ZhuangHT-1201/three-blade-folding-hub/figures/asm_deployed.png

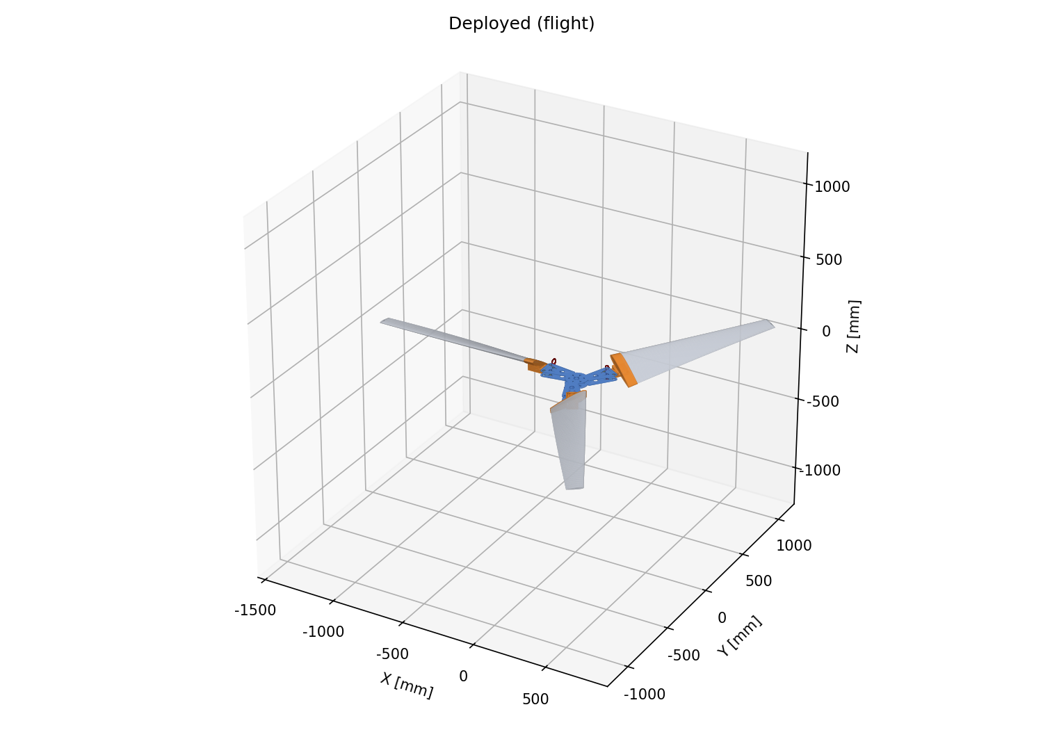
figures/asm_deployed.png
