ZhuangHT-1201/three-blade-folding-hub/figures/asm_midfold.png

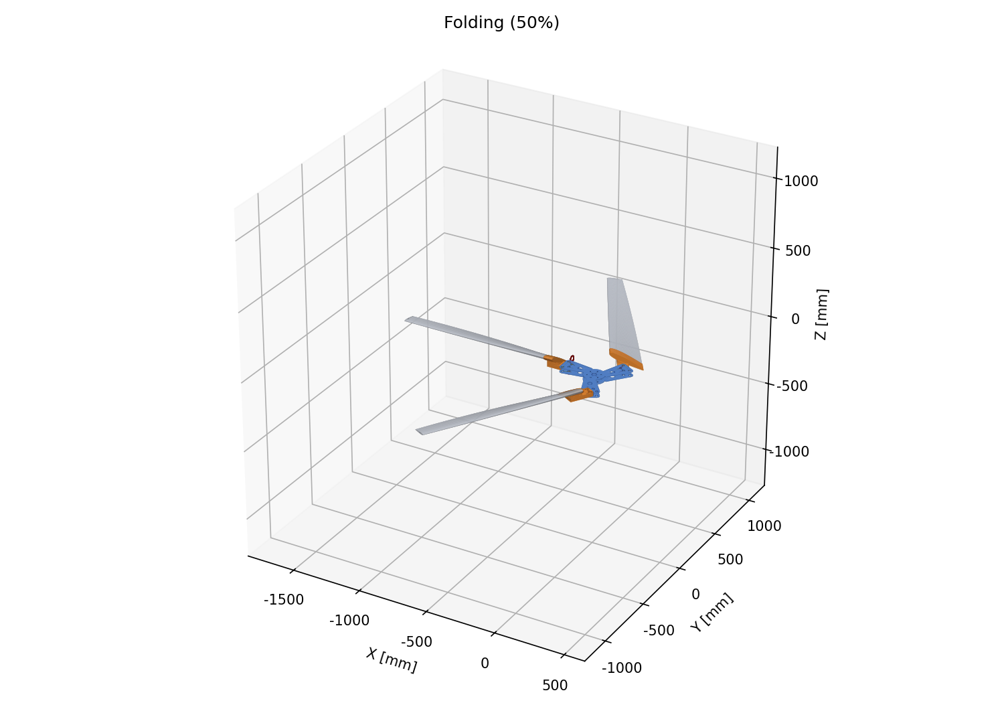
figures/asm_midfold.png
