ZhuangHT-1201/three-blade-folding-hub/preview.png

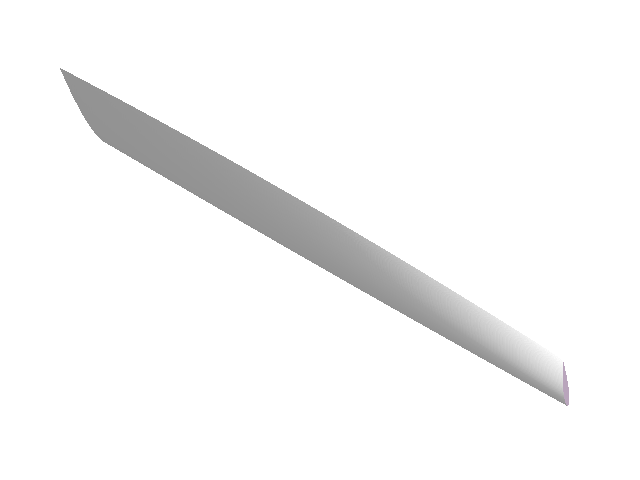
preview.png
