ZhuangHT-1201/three-blade-folding-hub/blade_rebuilt_mm.stl

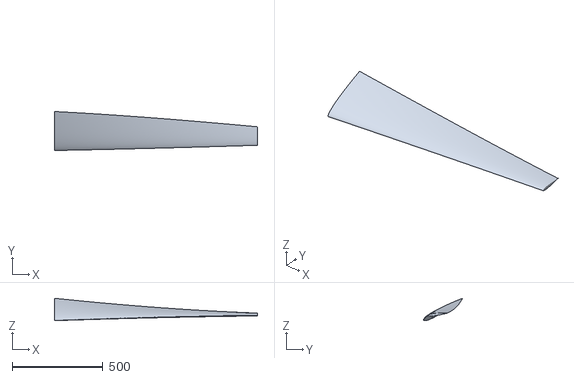
[picture p11: CAD file, 2026-10-12]
blade_rebuilt_mm.stl
1120.0 x 215.1 x 123.6
