ZhuangHT-1201/three-blade-folding-hub/blade_single.SLDPRT

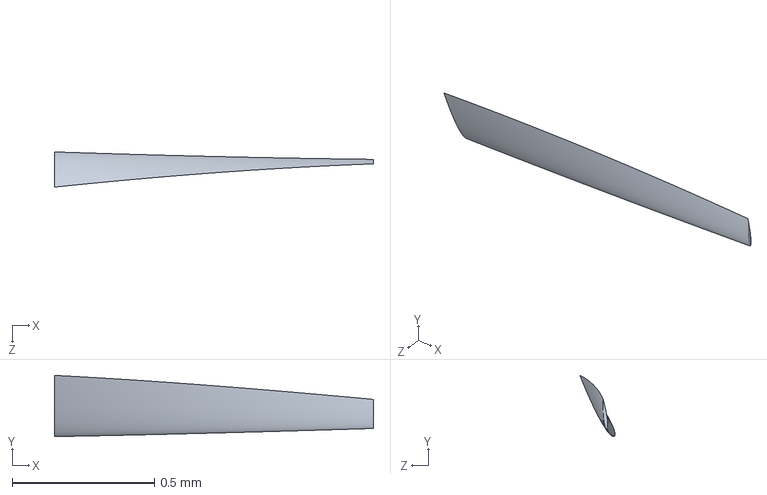
[picture p12: CAD file, 2026-10-12]
blade_single.SLDPRT
1.12 x 0.215 x 0.124 mm
