ZhuangHT-1201/three-blade-folding-hub/CAD/hub_spacer.step

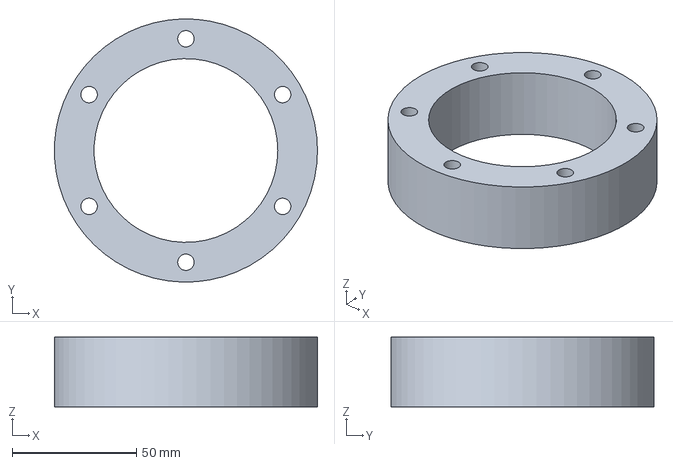
[picture p13: CAD file, 2026-10-12]
CAD/hub_spacer.step
105.9 x 106.0 x 28.0 mm
