ZhuangHT-1201/three-blade-folding-hub/CAD/hub_plate_lower.step

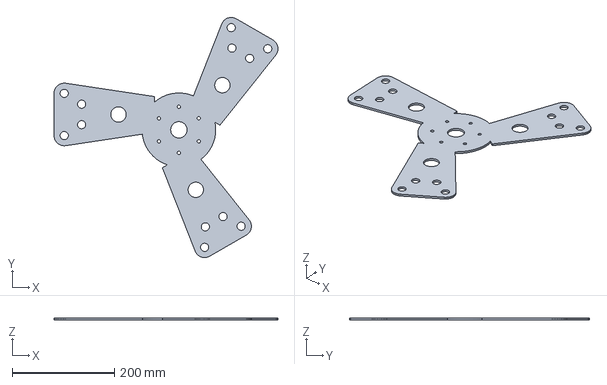
[picture p14: CAD file, 2026-10-12]
CAD/hub_plate_lower.step
437.5 x 469.0 x 4.00 mm
