ZhuangHT-1201/three-blade-folding-hub/CAD/blade_grip.step

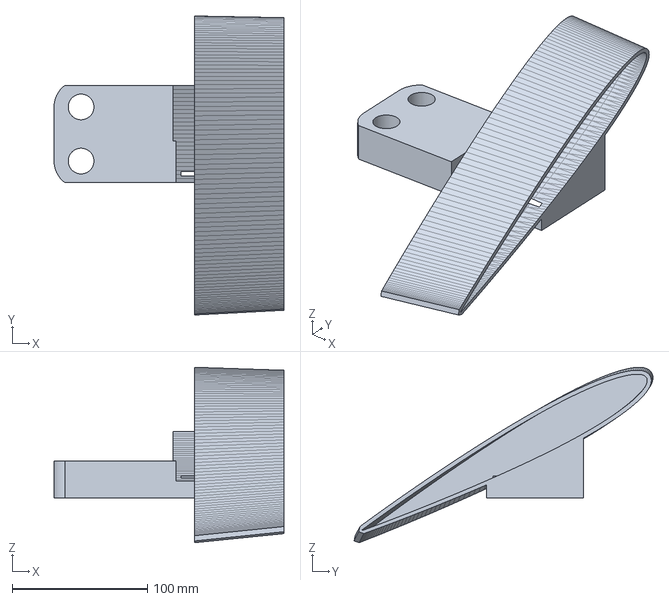
[picture p15: CAD file, 2026-10-12]
CAD/blade_grip.step
170.0 x 221.1 x 129.7 mm
