ZhuangHT-1201/three-blade-folding-hub/CAD/lock_pin.step

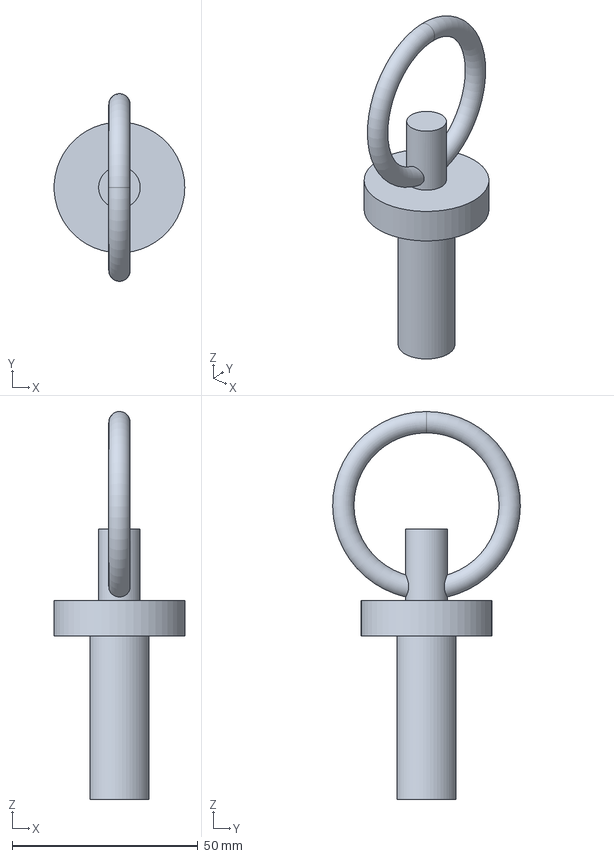
[picture p16: CAD file, 2026-10-12]
CAD/lock_pin.step
35.2 x 50.6 x 104.5 mm
