ZhuangHT-1201/three-blade-folding-hub/CAD/folding_hub.FCStd

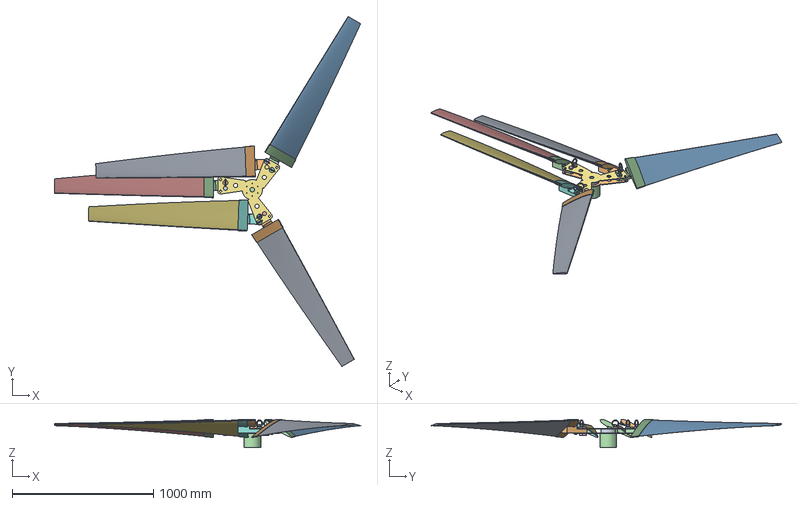
[picture p17: CAD file, 2026-10-12]
CAD/folding_hub.FCStd
2166.3 x 2475.9 x 201.0 mm
Deployed_plate_upper
Deployed_plate_lower
Deployed_spacer
Deployed_motor_ref
Deployed_A_blade
Deployed_A_grip
Deployed_A_sleeve1
Deployed_A_sleeve2
Deployed_A_pivot_bolt
Deployed_A_lock_pin
Deployed_B_blade
Deployed_B_grip
Deployed_B_sleeve1
Deployed_B_sleeve2
Deployed_B_pivot_bolt
Deployed_B_lock_pin
Deployed_C_blade
Deployed_C_grip
Deployed_C_sleeve1
Deployed_C_sleeve2
Deployed_C_pivot_bolt
Deployed_C_lock_pin
Folded_plate_upper
Folded_plate_lower
Folded_spacer
Folded_motor_ref
Folded_A_blade
Folded_A_grip
Folded_A_sleeve1
Folded_A_sleeve2
Folded_A_pivot_bolt
Folded_A_lock_pin
Folded_B_blade
Folded_B_grip
Folded_B_sleeve1
Folded_B_sleeve2
Folded_B_pivot_bolt
Folded_B_lock_pin
Folded_C_blade
Folded_C_grip
Folded_C_sleeve1
Folded_C_sleeve2
Folded_C_pivot_bolt
Folded_C_lock_pin
