ZhuangHT-1201/three-blade-folding-hub/CAD/sleeve_bushing.step

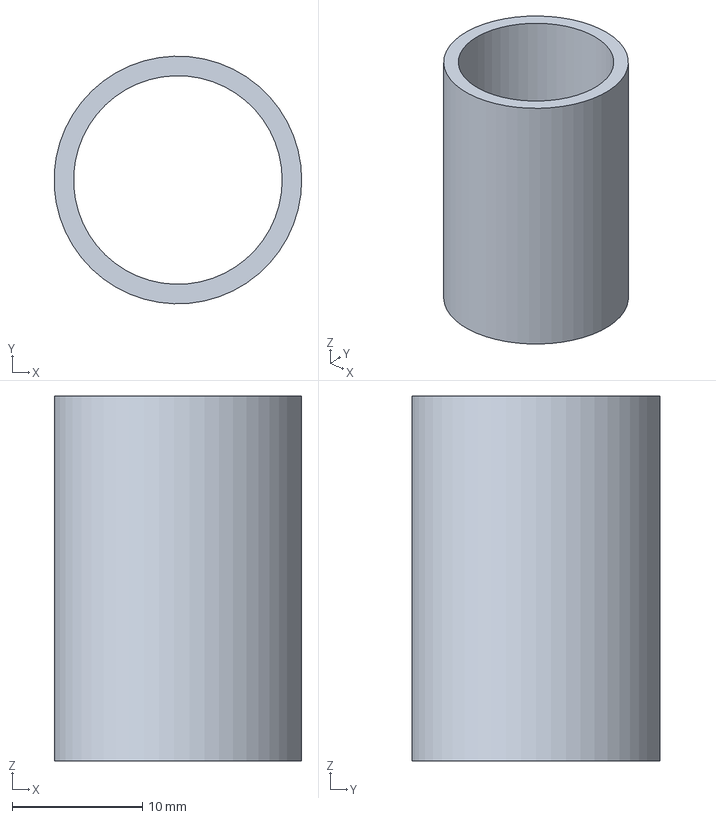
[picture p18: CAD file, 2026-10-12]
CAD/sleeve_bushing.step
19.0 x 19.0 x 28.0 mm
