ZhuangHT-1201/three-blade-folding-hub/CAD/pivot_bolt.step

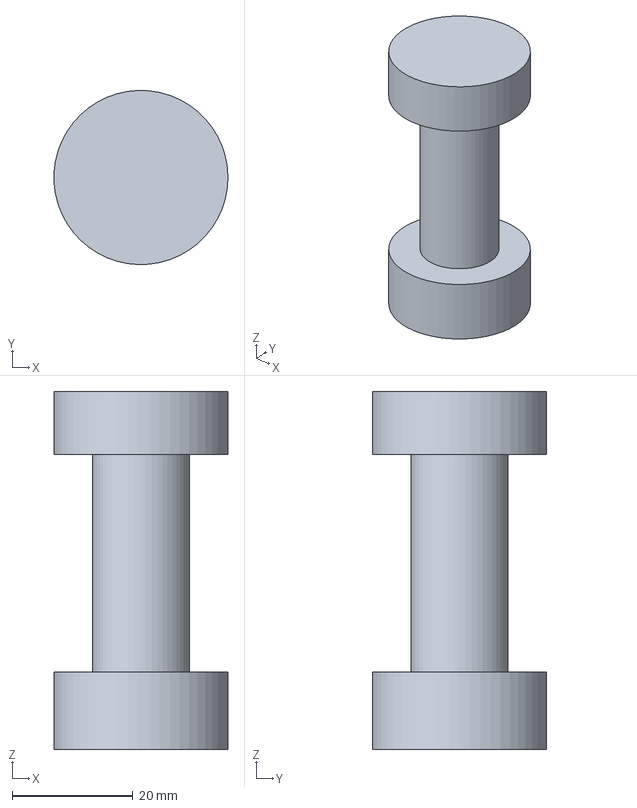
[picture p19: CAD file, 2026-10-12]
CAD/pivot_bolt.step
28.8 x 28.8 x 59.2 mm
