ZhuangHT-1201/three-blade-folding-hub/(list of files, cad)

Other CAD files:
CAD/hub_plate_upper.step
CAD/blade_design_frame.step
